Aarhus-University-MPE/Lake-Profiler/README.md

# Lake Profiler
