Aarhus-University-MPE/Lake-Profiler/(threads)

Thread 2 (2022-08-16):

Next alarm fails, when at last sample

MadsR, 2022-08-16:
Next alarm() when time is 23:00 fails to skip to next alarm.. Should be 5:00, check returns 23:00

MadsR, 2022-08-19:
Newest Update supposedly fixed 21-23 NextAlarm error

Closed 2022-09-30.

Thread 3 (2022-08-17):

Battery level readout LoRa include voltage

MadsR, 2022-08-17:
Include voltage in the low power LoRa error message

MadsR, 2022-08-19:
Added in latest commit.

Voltage/10 is broadcast in LowPower LoRa messages.

Closed 2022-08-19.

Thread 4 (2022-09-30):

Boot-up lock

MadsR, 2022-09-30:
Sometimes fail to boot up. Removing and reinserting BTN/MTR cable affects outcome.

MadsR, 2022-09-30:
Faulty connector determined as the error, causing noise on Extra_RS232_RX, halting system.

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

MadsR, 2022-09-30:
Disconnecting cables did not resolve the boot-stuck error

MadsR, 2022-10-04:
Inserting and quickly removing and reinserting power cable, the system boots up succesfully.

MadsR, 2022-11-07:
Error appear to be fixed with the added delay on boot-up

Closed 2022-11-07.

Thread 5 (2022-09-30):

High Current Draw

MadsR, 2022-09-30:
High current draw when Tether cable is connected, indicating relay error.

MadsR, 2022-09-30:
Relay was replaced and current draw dropped to expected values

Closed 2022-09-30.

Thread 6 (2022-10-04):

Move to bottom position when in Run mode

MadsR, 2022-10-04:
Instead of having to wait 15+ mins for it to move down in service, before flicking over to run.

System should move to bottom position when in Run mode, waiting for alarm.

MadsR, 2023-03-14:
**Motor Position Check ``1_AutonomyProcess.h``**
Added Motor Position check to ``case 0:`` of ``AutonomyState()``, should now move system to bottom position before starting, when autonomy process is initialized.

```cpp
void AutonomyState() {
...
    case 0:
      // Check if at bottom position before starting autonomy
      if (!MotorPositionReached(MOTOR_DIR_DOWN)) {
        autonomyState = 30;
      }
      // System at bottom position wait for alarm
      else if (AlarmStatus(RTCC_ALM0)) {
        autonomyState++;
        DEBUG_PRINTLN(F("Alarm case 0"));
      }
      break;
      ...
      // Move to bottom position
    case 30:
      DEBUG_PRINTLINE();
      DEBUG_PRINTLN(F("Moving to Bottom Position"));
      DEBUG_PRINTLINE();
      MotorMove(MOTOR_DIR_DOWN);
      autonomyState++;
      break;
    // Wait until bottom position is reached
    case 31:
      if (MotorPositionReached()) {
        MotorMove(MOTOR_DIR_HALT);
        autonomyState = 0;
      }
      break;
  }
}
```

Closed 2023-03-14.

Thread 7 (2022-10-04):

Single sample per day being error will repeat continuously

MadsR, 2022-10-04:
### Lake Profiler Version

0.4.13

### Area(s) with issue?

General, Other

### Steps to reproduce

Alarm set to 10:00, check power level: too low -> Set new alarm

If only 1 alarm per day it will set alarm to 10:00 again -> Alarm triggers instantly -> Check -> Reset Alarm.

### ✔️ Expected Behavior

_No response_

### ❌ Actual Behavior

_No response_

MadsR, 2023-03-02:
This issue has been temporarily resolved by adding two additional states to the AutonomyState()

```cpp
case 20:
  Check if loggingFrequency != 1:
      Start Next Alarm as usual
      Move to default state 0
  else:
      Start 1 hour timer to delay next alarm start
      Move to state 21

case 21:
  Check if 1 hour timer has elapsed:
      Move to defaul state 0
```

Closed 2023-03-02.

Thread 8 (2022-10-04):

Encoder depth calculations off

MadsR, 2022-10-04:
### Lake Profiler Version

0.4.13

### Area(s) with issue?

Sensors, Encoder

### Steps to reproduce

Encoder depth calculation off.

SetValue: 400 cm, depth reached: 280 cm
SetValue: 450 cm, depth reached:

### ✔️ Expected Behavior

_No response_

### ❌ Actual Behavior

_No response_

MadsR, 2023-03-02:
Encoder replaced with a time-based encoder addressed in #9

Closed 2023-03-02.

Thread 9 (2022-10-04):

Encoder Readings Jump

MadsR, 2022-10-04:
### Lake Profiler Version

0.4.13

### Area(s) with issue?

Encoder

### Steps to reproduce

Encoder Signal/Software/Readings sometimes jump several values.

### ✔️ Expected Behavior

_No response_

### ❌ Actual Behavior

_No response_

MadsR, 2022-10-17:
EncoderInterrupt, ignore B, use Software Direction

MadsR, 2022-11-07:
Large amount of EMI (electromagnetic interference) was observed at the lake which could explain the faulty readings, other sensors #10 also experienced faulty readings.

**Proposed solution 1**
Bevel Gear, Threaded Rod limit switch

- Mechanical Solution (robust)
- Adjustable (move limit switches, can build in depth markers)

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

**Proposed solution 2**
Wire Depth Markers + Reader. Add color or metal ring to wire at wanted depths along with a sensor to measure once positions are reached.

- Potentially Cheap
- Susceptible  to noise (depending on signal-type)
- Can deteriorate over time (build.-up on cable/marker from lake)

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

**Proposed solution 3**
Time-based depth movement

- Cheap
- Fast to implement
- Works without mechanical alterations
- Repeatbility might fail
  - Voltage/Tension will affect motor speed = depth reached

MadsR, 2022-11-22:
**Potential Solutions**
EMI hard to measure

- Individual source turned off and measure (then when you find culprit, can you even do something?)
- 3D mapping EMI (very expensive)

Measure noise

- Analog (PC powered) oscilloscope probe encoder lines

Noise Reduction

- Cover cables and sensor in tinfoil
- Twist cables

MadsR, 2023-03-02:
Time-based encoder (Solution 3) developed, tested, and is now installed and running on system.

Thread 10 (2022-11-07):

Battery Reading Spikes

MadsR, 2022-11-07:
### Lake Profiler Version

0.4.13

### Area(s) with issue?

Battery

### Steps to reproduce

After installing system on Lake, battery levels appear to be spiking from 0% to above 100%, fluctuating very rapidly even without any power consumption.

### ✔️ Expected Behavior

_No response_

### ❌ Actual Behavior

_No response_

MadsR, 2023-03-02:
Latest installation on Lake shows no System Power spikes.

Previous Issue remains unknown.

MadsR, 2023-03-09:
Large battery reading jump experienced after completed profile.

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

MadsR, 2023-03-14:
**Update** (9 days post battery drop)
System appear to be alive even while at very low voltages, will inspect battery status tomorrow.

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

MadsR, 2023-03-16:
**Battery and Solar Upgrade**
System was moved and installed on a CB-450 buoy, which is significantly larger.

3x15W solar panels (vs old 3x8W)
2x 28Ah batteries (vs old 1x50Ah ``Yuasa REC50-12 Industrial VRLA Battery``)

**Battery Status**
After installing battery readings seem unstable and fairly low.
After about 9 hours the battery readings stabilize.
The day after, the system was inspected as the battery voltage seemed low, so incorrect measurements were assumed. Direct battery measurement showed the system measuring correctly.

One of the two 28Ah batteries were replaced with the old (fully charged) 50Ah battery. Again initial readings show unstable battery readings. It could potentially be the batteries stabilizing (as they are installed in parallel), resulting in a high current draw and unstable voltage.

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

**Task**
Will continue to monitor the battery levels in the upcoming days to see if it stabilizes and potentially charges the system.

MadsR, 2023-03-17:
As expected the battery voltage has stabilized after about 6 hours.

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

Will continue to monitor the battery level over the upcoming days.

MadsR, 2023-04-21:
We have observed spikes occurring again after a profile has been completed. Based on this, we have formulated a new hypothesis: the relay may not be switching off correctly once the profile is completed, resulting in a continuous high current draw. This, in turn, causes the battery to drain and the measured voltage to decrease.

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

Thread 11 (2022-12-08):

Sample ID missing in datarecoder file format

MadsR, 2022-12-08:
### Lake Profiler Version

0.4.13

### Area(s) with issue?

Other

### Steps to reproduce

Logging data missing sample ID

### ✔️ Expected Behavior

_No response_

### ❌ Actual Behavior

_No response_

MadsR, 2023-01-31:
Sample ID is successfully appended to the file format

Closed 2023-01-31.

Thread 12 (2022-12-08):

Package identifier wrong

MadsR, 2022-12-08:
### Lake Profiler Version

0.4.13

### Area(s) with issue?

Buoy, Other

### Steps to reproduce

Instead of identifier 0xA the identifier uses the letter 'A', 0x41

### ✔️ Expected Behavior

_No response_

### ❌ Actual Behavior

_No response_

MadsR, 2023-03-14:
Fixed package identifier in ``datarecorder.h``, ``AppendPackageIdentifierToData()``

Previous
```cpp
identifierData[0] = 'A';
```
Fixed
```cpp
identifierData[0] = 0xA;
```

Closed 2023-03-14.

Thread 13 (2022-12-10):

Alarm Timing Start Hour

MadsR, 2022-12-10:
### Lake Profiler Version

0.24.21

### Area(s) with issue?

Buoy

### Steps to reproduce

Alarm Frequency set to 3
Alarm Start Hour set to 15:00

Alarm table should be
```
7:00
15:00
23:00
```

Alarm table ends up at
```
15:00
23:00
```

### ✔️ Expected Behavior

_No response_

### ❌ Actual Behavior

_No response_

MadsR, 2023-03-02:
For now this will be left as intentional as all alarm timings will be specified from the Start Hour going forward.

Closed 2023-03-02.

Thread 14 (2022-12-10):

Data Payload Parser

MadsR, 2022-12-10:
### Provide a description of requested docs changes

Documentation describing payload structure

```
// Payload Index
b[0] = package[2];
b[1] = package[3];
b[2] = package[4];
b[3] = package[5];

// Payload Identifier
b[0] = package[6];

// CH4 concentration Estimate
b[0] = package[7];
b[1] = package[8];
b[2] = package[9];
b[3] = package[10];

// CH4 concentration
b[0] = package[11];
b[1] = package[12];
b[2] = package[13];
b[3] = package[14];

// CO2 Raw values
b[0] = package[15];
b[1] = package[16];
b[2] = package[17];
b[3] = package[18];

// CO2 concentration
b[0] = package[19];
b[1] = package[20];
b[2] = package[21];
b[3] = package[22];

// Depth Values
b[0] = package[23];
b[1] = package[24];
b[2] = package[25];
b[3] = package[26];

// Temperatures
b[0] = package[27];
b[1] = package[28];
b[2] = package[29];
b[3] = package[30];

// Luminesence
b[0] = package[31];
b[1] = package[32];

// ID Sample
b[0] = package[34];
b[1] = package[35];

// Timestamp
b[0] = package[36];
b[1] = package[37];
b[2] = package[38];
b[3] = package[39];
```

MadsR, 2023-03-02:
Parser created and verified ``src/Python/payload.py``.

Closed 2023-03-02.

Thread 15 (2023-03-02):

CO2 Sensor Fails to Initialize

MadsR, 2023-03-02:
### Lake Profiler Version

0.4.83

### Area(s) with issue?

CO2 Sensor, Canister

### Steps to reproduce

Booting Canister from Buoy logging procedure.

### ✔️ Expected Behavior

Canister and sensors power up.

1. CH4 Sensor Initialize
2. CO2 Sensor Initialize
3. LUM sensor Initialize
4. Depth Sensor Initialize
5. Temp Sensor Initialize

### ❌ Actual Behavior

All sensors succesfully initialize and start communicating except for CO2 sensor.

MadsR, 2023-03-02:
**Possible Solution**
CO2 sensor might be slower to boot than Arduino, and CO2 sensor requires a start command to begin broadcast.

Delay (or reattempt) start commands after boot incase data is not valid

```cpp
  COM_CO2.write(0x1b);  // Initiate Communication
  delay(50);
  COM_CO2.write(0x31);  // Sensor ON
```

MadsR, 2023-03-14:
**VerifyCO2Stream**
Added ``VerifyCO2Stream()`` to ``CO2Read()``

```cpp
// Verify CO2 data stream is valid (new data acquired)
void VerifyCO2Stream() {
  if (co2Raw != -2) return;

  // No valid data received, reinitialize
  CO2Activate();
}

// Commands required to initialize CO2 sensor
void CO2Activate() {
  COM_CO2.write(0x1b);  // Initiate Communication
  delay(50);
  COM_CO2.write(0x31);  // Sensor ON
}

Additionally added ``150 ms`` delay to boot-up to avoid overloading system during boot.
```

Closed 2023-03-14.

Thread 16 (2023-03-02):

Incoorporate Minutes into Alarms

MadsR, 2023-03-02:
### Description of the new feature / enhancement

Instead of only triggering on hours trigger on both Hour and Minutes.

### Scenario when this would be used?

All alarms currently able to trigger from just Hours resulting in alarm spam when skipping a sample and logging frequency is once per day.

#7 did resolve this issue, but implementing minutes could prove useful.

### Supporting information

_No response_

Thread 18 (2023-03-02):

Mode Select Jumpers on PCB locks into Run mode

MadsR, 2023-03-02:
### Provide a description of requested docs changes

When setting system to Run mode with on-board PCB jumpers the external buttons are no longer able to switch mode.
This locks the system and should be significantly documented either on PCB or in some other way.

Insufficient documentation risk the issue of installing the system on the lake with the system being locked into a Run mode. Once locked requires the system to be fully uninstalled to access the PCB jumper.

Thread 20 (2023-03-02):

Improve Buttons usability

MadsR, 2023-03-02:
### Lake Profiler Version

1.02.15

### Area(s) with issue?

Buoy

### Steps to reproduce

Pressing Buttons to go Up, Down, or Setting Top Position

Pressing Up while currently going Down.

### ✔️ Expected Behavior

Reacting to a brief (20-50 ms) press and start moving.

If a button is pressed during movement the motor should stop.

### ❌ Actual Behavior

Sometimes system does not react to button presses instantly and requires a firmer press.

Pressing a button during movement sometimes result in motor starting to move directly after stopping.

Thread 21 (2023-03-02):

Low Power PCB mode

MadsR, 2023-03-02:
### Description of the new feature / enhancement

Heartbeat is sent every 15 min, Logging is done with hours interval.

Whenever the system is not active (or serviced) the system should be in a **Low Power mode**.

RTCC has a trigger out, which can be used to wake the MCU.
- ``Alarm1`` - Logging Alarm
- ``Alarm2`` - Heartbeat Alarm

Whenever a Button or Alarm triggers the MCU should wake.

### Scenario when this would be used?

The **Low Power mode** should reduce overall power consumption of the system.

Currently the Onboard MCU runs continuously drawing a significant amount of power continuously.

A lower standby power consumption allows for more frequent logging.

### Supporting information

MCU currently draws around 1-2 W continously, which is siginificant based on the 8W solar panels (x3).

Thread 22 (2023-03-02):

Add additional decimal to Battery Voltage message

MadsR, 2023-03-02:
### Description of the new feature / enhancement

Current version - sends battery voltage as ``Voltage x 10`` and converted to integer.

Proposed new method - send battery voltage as ``Voltage x 100`` and convert to integer.

### Scenario when this would be used?

Gives a better resolution of current battery voltage, and will give same resolution as debug terminal voltage readout.

### Supporting information

_No response_

MadsR, 2023-03-14:
**Added voltage x100 function and broadcast ``power.h``**

```cpp
// Return battery voltage x100 in Hex
uint16_t BatteryVoltageHex100() {
  return (uint16_t)(BatteryVoltage() * 100.0f);
}
```

**LoRa Broadcasts updated ``lora.h``**
```cpp
void LoRaBroadcastPowerLevel(){
  ...
  // High resolution Battery Voltage
  uint16_t voltage = BatteryVoltageHex100();

  cmdPtr += sprintf(cmdPtr, "AT+CMSGHEX=\"3 %02X %02X %02X\"\r\n", BatteryLevelHex(), voltage >> 8, (uint8_t)voltage);
  ...
}
```

```cpp
void LoRaBroadcastLowPower(){
  ...
  // High resolution Battery Voltage
  uint16_t voltage = BatteryVoltageHex100();

  cmdPtr += sprintf(cmdPtr, "AT+CMSGHEX=\"2 %02X %02X %02X %02X\"\r\n", BatteryLevelHex(), voltage >> 8,
  (uint8_t)voltage, NextAlarm());
  ...
}

```
**Updated ``battery.py``**
Download and formatter updated to accomodate new battery package

```py
# Extract integer from payload
def parsePayloadInt(payload, startIndex, length=4):
    # Add hex identifier
    byteString = ['0x' + s for s in payload[startIndex:startIndex+length]]

    # Convert to byteframe
    frame = b""
    for s in byteString:
        frame += bytes(int(s, 16).to_bytes(1, "little"))

    # Convert to integer values
    intValue = int.from_bytes(frame, "little", signed=True)

    return intValue
```

```py
# Extract payloads containing battery readings
for column in data.columns:
  ...
                voltage.append(parsePayloadInt(payload, 3, 2) / 100)
  ...
```

Closed 2023-03-14.

Thread 23 (2023-03-04):

CO2 failing to initialize

MadsR, 2023-03-04:
### Lake Profiler Version

0.4.83

### Area(s) with issue?

CO2 Sensor

### Steps to reproduce

Sensor fails to initialize on boot-up

Initiation communication message sent and start command sent.

### ✔️ Expected Behavior

```cpp
COM_CO2.write(0x1b);  // Initiate Communication
COM_CO2.write(0x31);  // Sensor ON
```

### ❌ Actual Behavior

No communication is initialized between Canister and CO2 sensor.

MadsR, 2023-03-04:
**Suggested Solution**
Re-attempt to initialize communication if sensor has not started succesfully.

Thread 25 (2023-03-14):

Add Legacy Payload parser to LoRa payload parsers

MadsR, 2023-03-14:
### Description of the new feature / enhancement

Add a boolean to enable legacy payloads

### Scenario when this would be used?

When inspecting data from before updated payload identifier and high resolution battery payload

### Supporting information

_No response_

MadsR, 2023-03-14:
**Legacy Boolean**
Added boolean to ``battery.py`` and ``profiles.py``, which allows legacy payloads to be parsed correctly.

```py
# Enable Legacy payloads
legacy = True
```
``battery.py``
```py
if (legacy):
  voltage.append(int('0x'+payload[3], 0) / 10)
else:
  voltage.append(parsePayloadInt(payload, 3, 2) / 100)
```

``profiles.py``
```py
if (legacy):
  identifier = 'A'
else:
  identifier = 10
```

Closed 2023-03-14.

Thread 26 (2023-03-16):

Tether Guide for rough weather

MadsR, 2023-03-16:
### Description of the new feature / enhancement

Add a tether guide for the system to avoid large winds affecting the system during use.

### Scenario when this would be used?

During use at high wind speeds and on large Buoys

### Supporting information

**CB-450**
Large Buoy Installed,
https://www.nexsens.com/pdf/CB450_drawings.pdf

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

**Supposed design**
14 cm between bolts
7 cm edge of bolt to edge

13,5 cm full width
16,5 cm full length

6-7 cm from outer edge to above waterline

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

Thread 27 (2023-03-17):

Battery Readings measuring charge voltage and not battery voltage

MadsR, 2023-03-17:
### Lake Profiler Version

1.03.31

### Area(s) with issue?

Buoy

### Steps to reproduce

Battery measurements with the current system and charge controller measure charging voltage and not battery voltage.

### ✔️ Expected Behavior

Charge controller sometimes have 3 ports.

- Solar Panel
- Battery
- Load

The ``Load`` port usually separates charging voltage coming from the solar panels.

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

This allows for a more accurate measurement of the battery voltage and the possibility of also measuring charge voltage separately.

### ❌ Actual Behavior

The current charge controller has no dedicated load port meaning measurements are made directly on the battery. The voltage is then raised whenever the system is charging resulting in only being able to measure the charging voltage.

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

Thread 28 (2023-04-19):

Motor Gear Breakdown

MadsR, 2023-04-19:
### Lake Profiler Version

1.03.31

### Area(s) with issue?

Other

### Steps to reproduce

Motor Gear broke while stationary, potentially due to high winds drawing on cable.

### ✔️ Expected Behavior

_No response_

### ❌ Actual Behavior

_No response_

MadsR, 2023-04-19:
Temporarily fixed by attaching a zip-tie to center ring.

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

Thread 29 (2023-04-20):

Low Package Size

MadsR, 2023-04-20:
### Lake Profiler Version

1.03.31

### Area(s) with issue?

Buoy

### Steps to reproduce

Some packages seem to be lost. Size of transferred profile is not consistent indicating some packages are never sent.

Could be due to low signal strength (snapped antenna).

**Potential fix**
Increase number of attempts to transmit before halting.

### ✔️ Expected Behavior

_No response_

### ❌ Actual Behavior

_No response_

Thread 30 (2023-06-29):

Canister Relay fails to Turn Off

MadsR, 2023-06-29:
### Lake Profiler Version

1.03.31

### Area(s) with issue?

Buoy

### Steps to reproduce

As reported in #10, the battery seem to fail to unlatch, resulting in a large continuous power draw.

### ✔️ Expected Behavior

_No response_

### ❌ Actual Behavior

_No response_
