Aarhus-University-MPE/Lake-Profiler/src/arduino/BuoyMainframe/config/constants.h

/*
  Lake Profiler system constants

  Mads Rosenhøj Jepepsen
  Aarhus University
  2021
*/

#pragma once

#include "../modules/setup/modules.h"

// ------------------------------------------------------------ //
//                            DEBUG                             //
// ------------------------------------------------------------ //

// Debug configuration flag - Comment out to unset
#define DEBUG_BLACKBOX_AND_PRINT
// #define DEBUG_BLACKBOX
// #define DEBUG_SERIAL
// #define DEBUG_NONE

// Executes if DEBUG flag is set.
#if defined(DEBUG_BLACKBOX_AND_PRINT)
#define DBG_ONLY(x) x
#define DEBUG_PRINT(x) \
  BlackBoxAppend(x);   \
  Serial.print(x)
#define DEBUG_PRINT2(x, y) \
  BlackBoxAppend(x, y);    \
  Serial.print(x, y)
#define DEBUG_PRINTLN(x) \
  BlackBoxAppendln(x);   \
  Serial.println(x)
#define DEBUG_PRINTLN2(x, y) \
  BlackBoxAppendln(x, y);    \
  Serial.println(x, y)
#define DEBUG_PRINTLINE() \
  Serial.println(F("------------------------------------"))
#define DEBUG_WRITE(x) Serial.write(x)
#define RECEIVE_CMDS() recvWithStartEndMarkers()
#endif

#if defined(DEBUG_BLACKBOX)
#define DBG_ONLY(x)
#define DEBUG_PRINT(x)       BlackBoxAppend(x)
#define DEBUG_PRINT2(x, y)   BlackBoxAppend(x, y)
#define DEBUG_PRINTLN(x)     BlackBoxAppendln(x)
#define DEBUG_PRINTLN2(x, y) BlackBoxAppendln(x, y)
#define DEBUG_PRINTLINE()
#define DEBUG_WRITE(x)
#define RECEIVE_CMDS()
#endif

#if defined(DEBUG_SERIAL)
#define DBG_ONLY(x)          x
#define DEBUG_PRINT(x)       Serial.print(x)
#define DEBUG_PRINT2(x, y)   Serial.print(x, y)
#define DEBUG_PRINTLN(x)     Serial.println(x)
#define DEBUG_PRINTLN2(x, y) Serial.println(x, y)
#define DEBUG_PRINTLINE()    Serial.println(F("------------------------------------"))
#define DEBUG_WRITE(x)       Serial.write(x)
#define RECEIVE_CMDS()       recvWithStartEndMarkers()
#endif

#if defined(DEBUG_NONE)
#define DBG_ONLY(x)
#define DEBUG_PRINT(x)
#define DEBUG_PRINT2(x, y)
#define DEBUG_PRINTLN(x)
#define DEBUG_PRINTLN2(x, y)
#define DEBUG_PRINTLINE()
#define DEBUG_WRITE(x)
#define RECEIVE_CMDS()
#endif

#define ToBoolString(m)           ((m) == 1 ? "T" : ((m) == 0 ? "F" : "Unknown"))
// ------------------------------------------------------------ //
//                           SYSTEM                             //
// ------------------------------------------------------------ //
#define SystemVersion             "1.03.31"

// Button debounce
#define BUTTON_DBOUNCE_TIME       50
#define BUTTON_DBOUNCE_TIME_LONG  1000

// Sensor and Module status
#define SYSTEM_CHECK_DT           1000
#define SYSTEM_REBOOT_DT          5000

// ------------------------------------------------------------ //
//                       STRATEGY MODES                         //
// ------------------------------------------------------------ //

#define MODES_MAX                 3  // Total number of modes
#define MODES_MIN_BROWSABLE       1  // Minimum mode index, that could be set via mode button.

#define MODE_SYSTEMTEST           0  // Test main systems
#define MODE_AUTONOMOUS           1  // Autonomous driving mode
#define MODE_SERVICE              2  // Service mode

#define ModeToString(m)           ((m) == 0 ? "System Test" : ((m) == 1 ? "Autonomous" : ((m) == 2 ? "Service" : "Unknown")))

// ------------------------------------------------------------ //
//                         HEARTBEAT                            //
// ------------------------------------------------------------ //
#define HRTBEAT_FRQ_OUT           1  // times per minute
#define HRTBEAT_DT_OUT            60000 / HRTBEAT_FRQ_OUT

#define HRTBEAT_TRESHOLD          300000  // Treshold for late heartbeat

#define BACKUP_RST_DT             300000  // Time between each reset attempt

#define HRTBEAT_DT_LOG            300000  // Time between system status log

// ------------------------------------------------------------ //
//                           BATTERY                            //
// ------------------------------------------------------------ //

#define BATTERY_MIN_LEVEL         50

#define BATTERY_VOLTAGE_MIN       10.7f
#define BATTERY_VOLTAGE_MAX       12.6f

// ------------------------------------------------------------ //
//                           MOTORS                             //
// ------------------------------------------------------------ //

#define MOTOR_DIR_UP              1
#define MOTOR_DIR_DOWN            2
#define MOTOR_DIR_SERVICE         3
#define MOTOR_DIR_HALT            0

#define MOTOR_SPEED               0.72f  // centimeter per second approximated (2*pi*95 mm)

#define ENCODER_UPDATE_PERIOD     250
#define TIMEOUT_SET_POS           5000

#define ENCODER_WHEEL_DIAMETER    0.2f

#define ENCODERMODE_SICK          0
#define ENCODERMODE_TIME          1

#define TIME_ENCODER_TOP_POSITION 36000000UL

// ------------------------------------------------------------ //
//                        COMMUNICATION                         //
// ------------------------------------------------------------ //

// Buttons
#define BTN_DEBOUNCE_TIME         500
#define ESTOP_DEBOUNCE_TIME       1000

// DEBUG
#define DEBUG_BAUDRATE            115200

// Canister Comm (RS232)
#define CANISTER_BAUDRATE         19200
#define LOGGING_START_TIMEOUT     3000000

// LORA
#define COM_LORA_BAUDRATE         9600
#define LORA_FREQUENCY            434.0
#define CLIENT_ADDRESS            1
#define SERVER_ADDRESS            2
#define MAX_LORA_BROADCAST        10
#define LORA_BROADCAST_DELAY      5000
#define LORA_HEARTBEAT_PERIOD     900000L  // 15 min
#define LORA_ACTIVE               true
