Aarhus-University-MPE/Lake-Profiler/src/arduino/BuoyMainframe/modules/system/power.h

/*
  Lake Profiler Power control

  Mads Rosenhøj Jepepsen
  Aarhus University
  2022
*/

#pragma once

#include "../setup/modules.h"

// BatteryReading = 3 kOhm / (3 kOhm + 9 kOhm) * Battery Voltage
// 12.6V .. 10.5V -> ~3.15V .. 2.65V -> 645 .. 542
const float batteryScaleA = 28.722f;
const float batteryScaleB = -617.39f;
const float batteryOffset = 3318.3f;

const float batteryVoltageOffset = 0.1f;

int BatteryLevel() {
  float batteryVoltage = BatteryVoltage();

  // Check over/under charged
  if (batteryVoltage < BATTERY_VOLTAGE_MIN) return 0;
  if (batteryVoltage > BATTERY_VOLTAGE_MAX) return 100;

  float batteryLevel = batteryScaleA * batteryVoltage * batteryVoltage + batteryScaleB * batteryVoltage + batteryOffset;

  return (int)batteryLevel;
}

// Return battery Level in Hex
uint8_t BatteryLevelHex() {
  return (uint8_t)BatteryLevel();
}

// Return battery voltage x10 in Hex
uint8_t BatteryVoltageHex() {
  return (uint8_t)(BatteryVoltage() * 10.0f);
}

// Return battery voltage x100 in Hex
uint16_t BatteryVoltageHex100() {
  return (uint16_t)(BatteryVoltage() * 100.0f);
}

// Checks voltage levels above critical values?
bool VoltageCheck() {
  return BatteryLevel() > GetBatteryMinLevel();
}

float BatteryVoltage() {
  int voltageInt = analogRead(PA_SENSOR_BATT);

  float voltageRead = voltageInt * 5.0f / 1024.0f;

  float voltageBattery = voltageRead * 12.0f / 3.0f + batteryVoltageOffset;

  return voltageBattery;
}

// Returns current battery status > minimum battery level
bool BatteryStatus() {
  return VoltageCheck();
}

// Returns minimum battery level from EEPROM
uint8_t GetBatteryMinLevel() {
  return EEPROM_READ_INT(MEMADDR_BATTERY_MIN);
}

// Sets EEPROM minimum battery level
void SetBatteryMinLevel(uint8_t batteryLevel) {
  DEBUG_PRINT(F("Setting min battery level: "));
  DEBUG_PRINT(batteryLevel);
  DEBUG_PRINTLN(F(" %"));
  EEPROM_WRITE_INT(MEMADDR_BATTERY_MIN, batteryLevel);
}

bool BatteryStatus(bool print) {
  if (!print) {
    return VoltageCheck();
  }

  DEBUG_PRINT(F("Battery Level: "));
  DEBUG_PRINTLN(BatteryLevel());

  DEBUG_PRINT(F("Battery Voltage: "));
  DEBUG_PRINTLN(BatteryVoltage());
  return VoltageCheck();
}

void StandbyMode() {
  // LowPower.powerDown(SLEEP_FOREVER, ADC_OFF, BOD_OFF);
}

void wakeUp() {
  // Just a handler for the pin interrupt.
}
