Aarhus-University-MPE/Lake-Profiler/src/arduino/CanisterMainframe/Sen_Depth_BR_Bar100.ino

/*
    Depth sensor (Blue Robotics Bar100), handles reading sensor output.

    Component:
      https://bluerobotics.com/store/sensors-sonars-cameras/sensors/bar100-sensor-r2-rp/

    <TODO: Temporary, until replacement arrives:
      https://bluerobotics.com/store/sensors-sonars-cameras/sensors/bar30-sensor-r1/

    Primary Library:
      https://github.com/bluerobotics/BlueRobotics_KellerLD_Library

    By
    Mads Rosenhoej Jeppesen - Aarhus 2021
    mrj@mpe.au.dk
*/

#include "KellerLD.h"
KellerLD bar100Sensor;

bool DepthInitialize() {
  bar100Sensor.init();
  bar100Sensor.setFluidDensity(997);  // kg/m^3 (freshwater, 1029 for seawater)

  return bar100Sensor.isInitialized();
}

void DepthTerminate() {
}

bool DepthStatus() {
  return GetStatus(MODULE_DEPTH);
}

bool DepthTest() {
  bar100Sensor.read();

  DEBUG_PRINT(F("Pressure: "));
  DEBUG_PRINT(bar100Sensor.pressure());
  DEBUG_PRINTLN(F(" mbar"));

  DEBUG_PRINT(F("Temperature: "));
  DEBUG_PRINT(bar100Sensor.temperature());
  DEBUG_PRINTLN(F(" deg C"));

  DEBUG_PRINT(F("Depth: "));
  DEBUG_PRINT(bar100Sensor.depth());
  DEBUG_PRINTLN(F(" m"));

  DEBUG_PRINT(F("Altitude: "));
  DEBUG_PRINT(bar100Sensor.altitude());
  DEBUG_PRINTLN(F(" m above mean sea level"));

  return true;
}

void DepthRead() {
  bar100Sensor.read();
}

float GetDepth() {
  bar100Sensor.read();
  return bar100Sensor.depth();
}
