Aarhus-University-MPE/Lake-Profiler/src/arduino/_BuoyMainframe/Str_Example.ino

/*  XX mode

    Description...
*/

// Start sequence of strategy
void StartStrategyExample() {
  DEBUG_PRINTLINE();
  DEBUG_PRINT(F("Strategy (Example): Emergency Starting..."));

  // Disable all outputs
  ModuleDisable();

  ModuleEnableMode();

  DEBUG_PRINTLN(F("Strategy (Idle): Initialized"));
  DEBUG_PRINTLINE();
}

// Main sequence of strategy
void RunStrategyExample() {
  //

}

// End sequence of strategy
void FinishStrategyExample() {
  DEBUG_PRINTLINE();
  DEBUG_PRINTLN(F("Strategy (Example): Ending"));
  ModuleDisable();

  DEBUG_PRINTLN(F("Strategy (Example): Finished"));
}
