Aarhus-University-MPE/Lake-Profiler/(commit log)

2021-11-15 Sensor Framework
2022-03-14 Project Restructure
    Not currently Compiling, needs further fixes.
    [Buoy.cpp, CanisterMainframe.ino, Com_USB.ino, Control.cpp, Heartbeat.cpp]
2022-03-16 HydroC - CH4 sensor
2022-04-05 Minor Cleanup and Pin assignments
2022-05-06 Sensor Read and Communication
    [SD_datafile_20220316_094455CH4T-1120-001.csv]
2022-05-09 First minor system test reworks
    [BuoyMainframe.ino, CanisterMainframe.ino, Com_Buoy.ino, Com_Lora.ino, Com_USB.ino, Logging.h]
2022-05-10 Tether Comm and Power
    System setup configuration and setup for initial tether communication
2022-05-19 Onboard System Test
    [HexTable.xlsx]
2022-05-20 encoder power management
2022-06-10 Iridium System Test
    [SD_datafile_20220316_094455CH4T-1120-001.csv]
2022-08-12 Canister Sensor Printouts
2022-08-17 Alarm Timing Fix (NextAlarm) & LoRa power error
    [alarm.h, lora.h, power.h]
2022-08-21 Power Level Rework
    Reworked to 2nd order voltage to battery level
    [constants.h, lora.h, power.h]
2022-08-25 LoRa data grabber (Python)
    [LoRa_attery.csv, battery.csv]
2022-08-29 LoRa Power inspection
    [battery.csv]
2022-08-29 LoRa 15 min heartbeat
    Broadcasts power status every 15 min.
2022-09-01 Minor LoRa Data Representation
    [battery.csv]
2022-09-20 Battery Test
    [battery.csv]
2022-09-28 Top Position Set, Start Hour
    Top Position change to Press and Hold -> Setting top position
    SetStartHour USB now functions
    [battery.csv]
2022-10-04 LoRa Encoder Error broadcast prep
    [encoder.h, lora.h]
2022-11-22 Depth and Time Encoder Rework
    [battery.csv]
2022-12-14 Payload extraction Script
    [battery.csv, payload.csv, payloadExtract.csv, payloadExtractFormatted.csv]
2022-12-15 Minor formatting
    [battery.csv]
2023-02-27 CH4 and CO2 Sensor system Test
    Modified data index for CH4 sensor and Start command for CO2
    [payload.csv, payloadExtract.csv, payloadExtractFormatted.csv]
2023-03-02 loggingFrequency = 1 low power error
    [alarm.h]
2023-03-02 Payload Parser
    Battery voltage Added
    Duplicate scan and ignore
    [LoRa_attery.csv, battery.csv, payload.csv, payloadExtract.csv, payloadExtractFormatted.csv]
2023-03-02 Payload Parser
    [battery.csv, payload.csv, payloadExtract.csv, payloadExtractFormatted.csv]
2023-03-04 Python Scripts Documentation and Cleanup
    [battery.csv, payload.csv, payloadExtract.csv, payloadExtractFormatted.csv]
2023-03-14 Large System Rework
    Fixed Payload Identifer
    Increased Battery Voltage Resolution
    Potential fix for CO2 Sensor Initialization
    Data Payload parser updated for new Battery Voltage Payload
    Profile Payload parser updated for new package identifier
    Added legacy payload option to Battery parser
    Added legacy payload option to Profile parser
    System moves to bottom when moved into autonomous mode before starting autonomy
    [battery.csv, payload.csv, payloadExtract.csv, payloadExtractFormatted.csv]
2023-03-14 Added savefig to battery payload parser
    [battery.csv]
2023-03-15 Battery Graph Legend added
    [battery.csv]
2023-03-15 Added R variant of battery.py
2023-03-16 Autonomy Move to Bottom rework
    [battery.csv]
2023-03-16 Battery Graph Format
    [battery.csv]
2023-03-16 Battery Graph Style
    [battery.csv]
2023-03-16 Battery Graph Script cleanup
    [battery.csv]
2023-04-19 LoRa Scraper Format
    [battery.csv, payload.csv, payloadExtract.csv, payloadExtractFormatted.csv]
2023-04-21 raw profiles parser
    [battery.csv, payload.csv, payloadExtract.csv, payloadExtractFormatted.csv]
2023-04-21 LoRa Broadcast Attempts increase, File Scraper
    [battery.csv]
2023-08-22 Sleep mode Preliminary
    [battery.csv, payload.csv, payloadExtract.csv, payloadExtractFormatted.csv]
